carlosgj/Erin-Orion-Avionics/LED Board.brd

## EAGLE design LED Board.brd (2023-04-09)

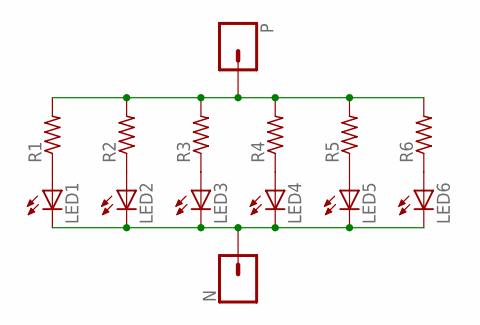
[picture p1: schematic LED Board.sch]

Parts:
LED1, LED2, LED3, LED4, LED5, LED6: LEDCHIPLED_1206; CHIPLED_1206
N: CONN_01; 1X01
P: CONN_01; 1X01
R1, R2, R3, R4, R5, R6: R-US_M1206; M1206

Connections:
unnamed: LED1.A, R1.1
unnamed: LED2.A, R2.1
unnamed: LED3.A, R3.1
unnamed: LED4.A, R4.1
unnamed: LED5.A, R5.1
unnamed: LED6.A, R6.1
unnamed: P.1, R1.2, R2.2, R3.2, R4.2, R5.2, R6.2
unnamed: LED1.C, LED2.C, LED3.C, LED4.C, LED5.C, LED6.C, N.1

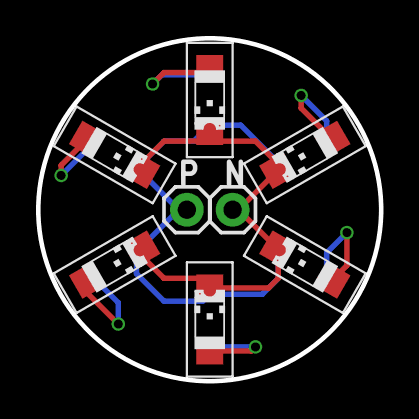
[picture p2: board LED Board.brd from above]

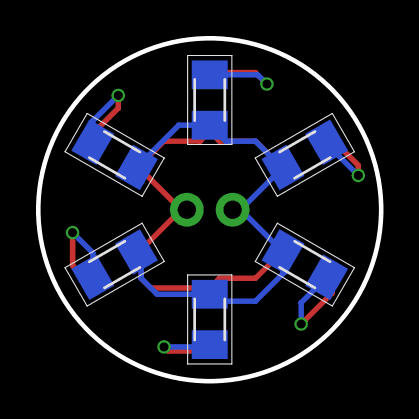
[picture p3: board LED Board.brd from below]

Board: 2 copper layers, 19.1 x 19.1 mm, 14 parts (6 on the bottom side), 8 nets.
