carlosgj/Erin-Orion-Avionics/Button Board.brd

## EAGLE design Button Board.brd (2023-03-30)

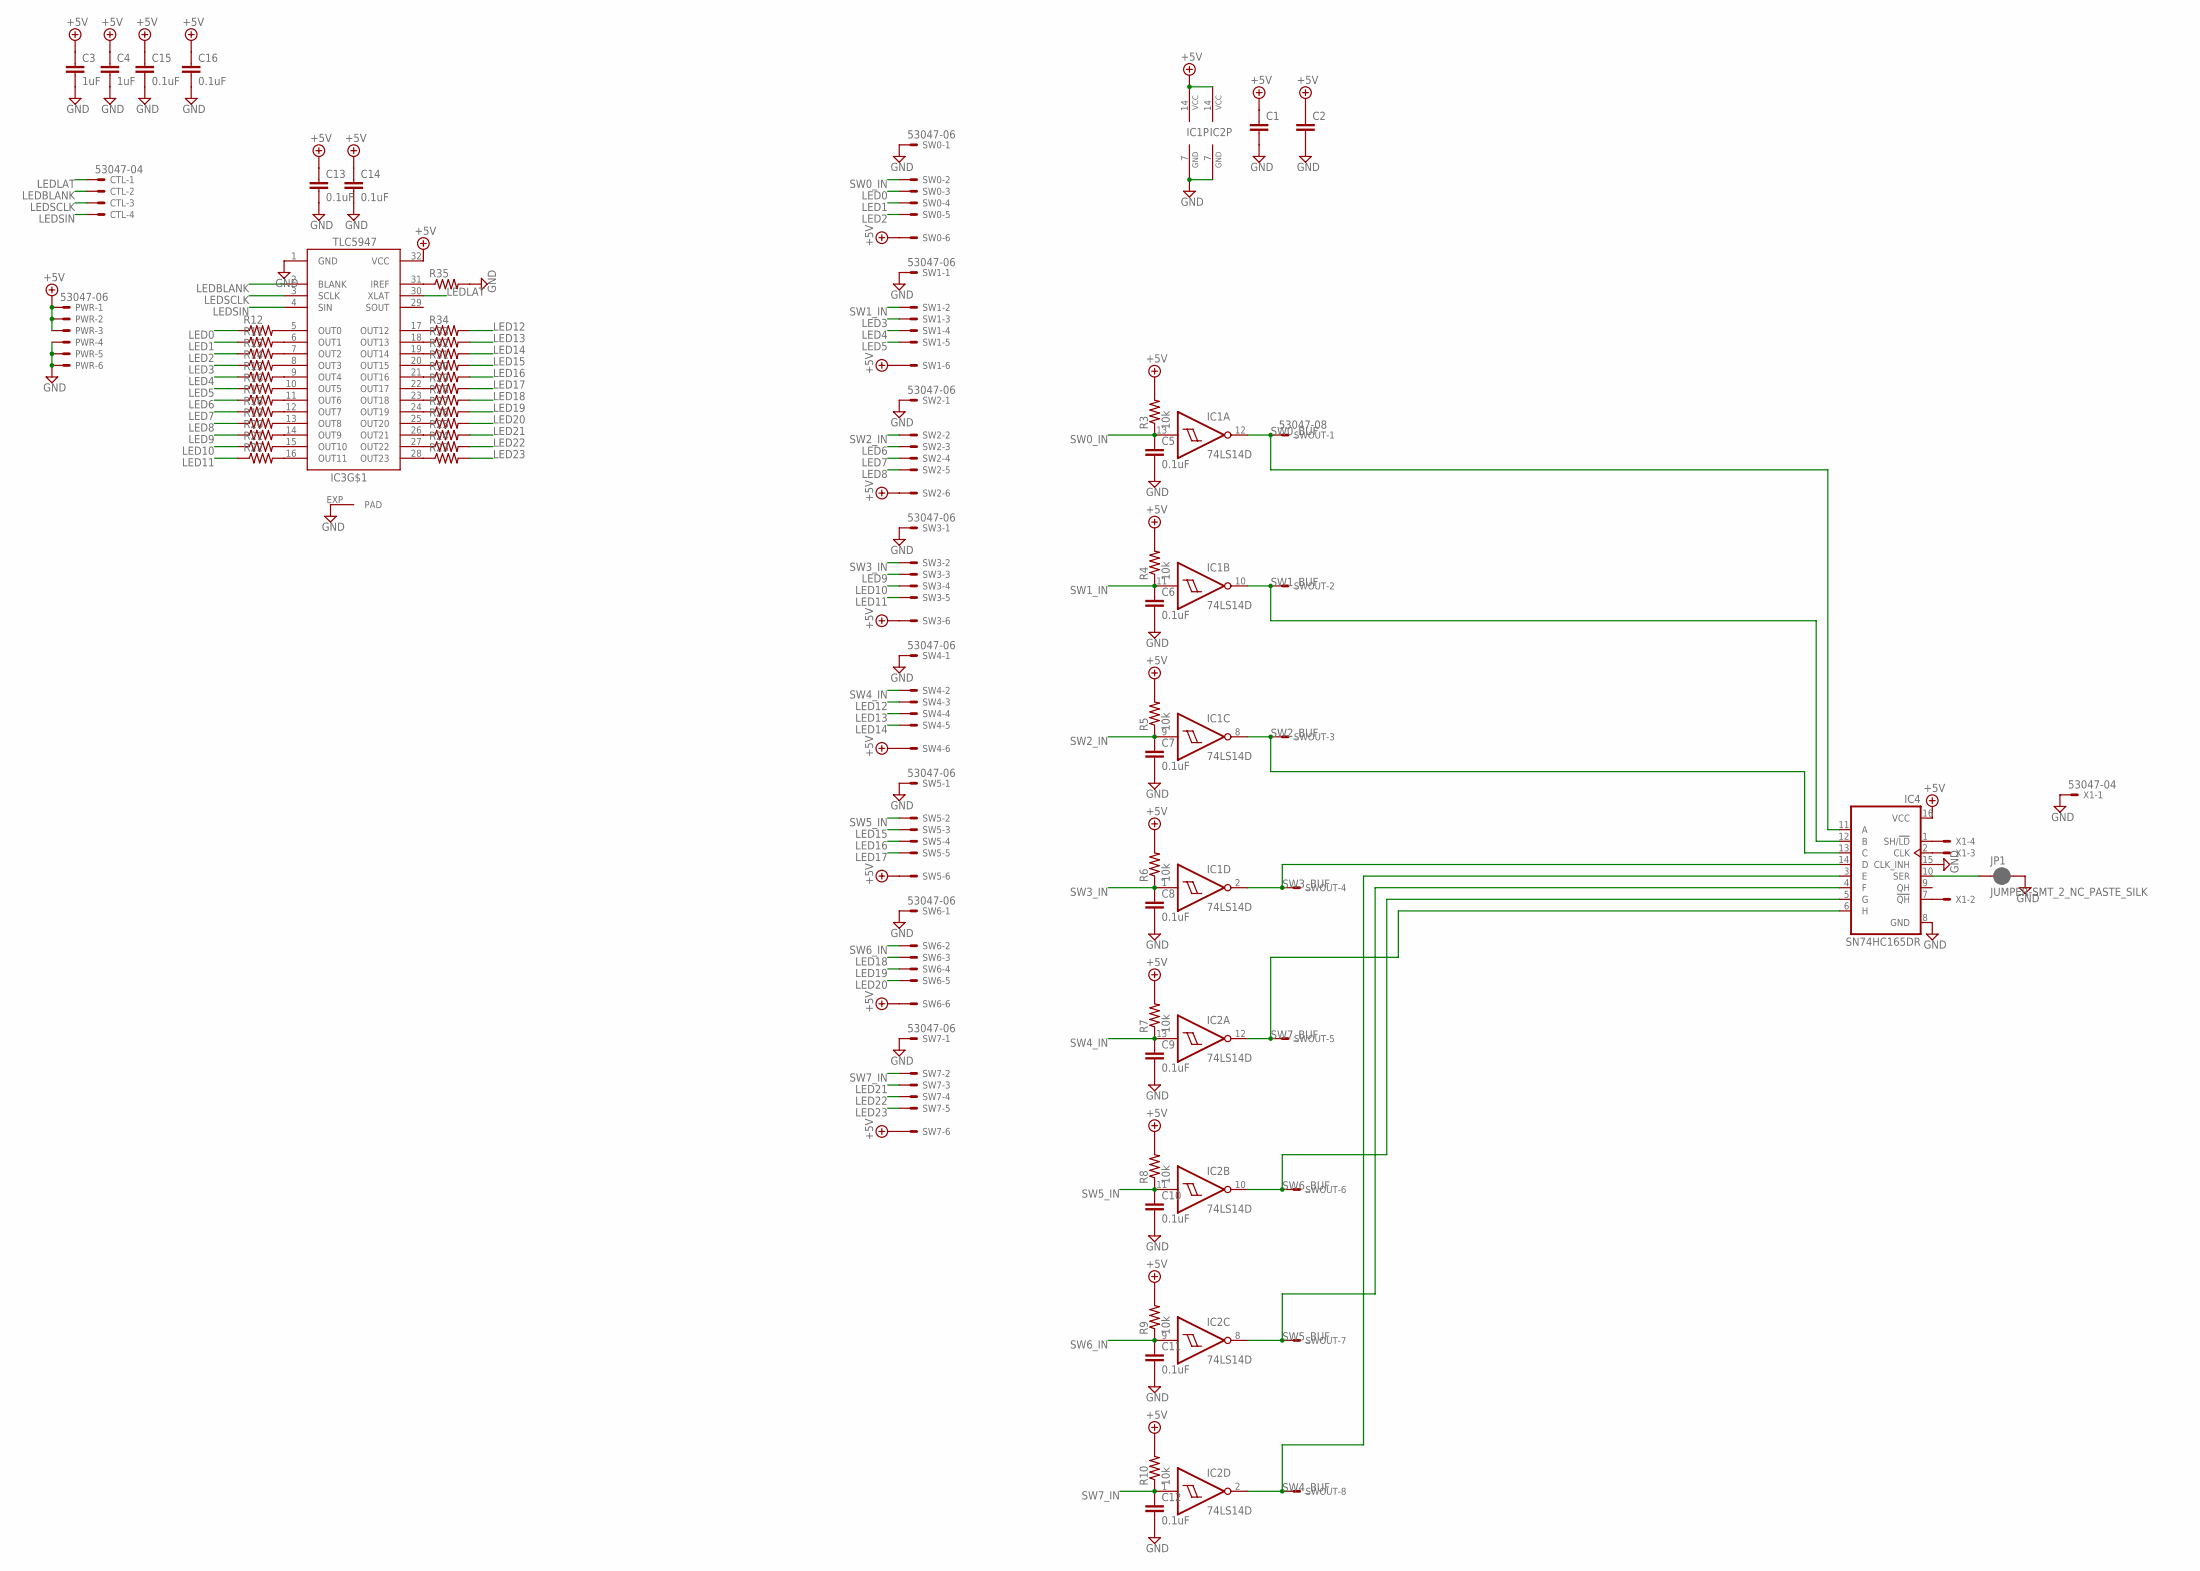
[picture p4: schematic Button Board.sch, Buttons]

Parts:
C1, C2: C-EUC1206; C1206
C3, C4: 1uF; C1206K
C5, C6, C7, C8, C9, C10, C11, C12, C13, C14: 0.1uF; C1206
C15, C16: 0.1uF; C1206K
CTL: 53047-04
IC1, IC2: 74LS14D; SO14
IC3: TLC5947-DAP; HTSSOP32DAP
IC4: SN74HC165DR; SO16
JP1: JUMPER-SMT_2_NC_PASTE_SILK; SMT-JUMPER_2_NC_PASTE_SILK
PWR: 53047-06
R3, R4, R5, R6, R7, R8, R9, R10: 10k; M1206
R11, R12, R13, R14, R15, R16, R17, R18, R19, R20, R21, R22, R23, R24, R25, R26, R27, R28, R29, R30, R31, R32, R33, R34, R35: R-US_M1206; M1206
SW0, SW1, SW2, SW3, SW4, SW5, SW6, SW7: 53047-06
SWOUT: 53047-08
X1: 53047-04

Connections:
+5V: C1.1, C2.1, C3.1, C4.1, C13.1, C14.1, C15.1, C16.1, IC1.14 (VCC), IC2.14 (VCC), IC3.32 (VCC), IC4.16 (VCC), PWR.1, PWR.2, PWR.3, R3.2, R4.2, R5.2, R6.2, R7.2, R8.2, R9.2, R10.2, SW0.6, SW1.6, SW2.6, SW3.6, SW4.6, SW5.6, SW6.6, SW7.6
GND: C1.2, C2.2, C3.2, C4.2, C5.2, C6.2, C7.2, C8.2, C9.2, C10.2, C11.2, C12.2, C13.2, C14.2, C15.2, C16.2, IC1.7 (GND), IC2.7 (GND), IC3.1 (GND), IC3.EXP (PAD), IC4.8 (GND), IC4.15 (CLK_INH), JP1.2, PWR.4, PWR.5, PWR.6, R35.2, SW0.1, SW1.1, SW2.1, SW3.1, SW4.1, SW5.1, SW6.1, SW7.1, X1.1
LED0: R12.1, SW0.3
LED1: R11.1, SW0.4
LED2: R13.1, SW0.5
LED3: R14.1, SW1.3
LED4: R15.1, SW1.4
LED5: R16.1, SW1.5
LED6: R17.1, SW2.3
LED7: R18.1, SW2.4
LED8: R19.1, SW2.5
LED9: R20.1, SW3.3
LED10: R21.1, SW3.4
LED11: R22.1, SW3.5
LED12: R34.2, SW4.3
LED13: R33.2, SW4.4
LED14: R32.2, SW4.5
LED15: R31.2, SW5.3
LED16: R30.2, SW5.4
LED17: R29.2, SW5.5
LED18: R28.2, SW6.3
LED19: R27.2, SW6.4
LED20: R26.2, SW6.5
LED21: R25.2, SW7.3
LED22: R24.2, SW7.4
LED23: R23.2, SW7.5
LEDBLANK: CTL.2, IC3.2 (BLANK)
LEDLAT: CTL.1, IC3.30 (XLAT)
LEDSCLK: CTL.3, IC3.3 (SCLK)
LEDSIN: CTL.4, IC3.4 (SIN)
unnamed: IC4.1 (SH/!LD), X1.4
unnamed: IC4.2 (CLK), X1.3
unnamed: IC3.5 (OUT0), R12.2
unnamed: IC3.6 (OUT1), R11.2
unnamed: IC3.7 (OUT2), R13.2
unnamed: IC3.8 (OUT3), R14.2
unnamed: IC3.9 (OUT4), R15.2
unnamed: IC3.11 (OUT6), R17.2
unnamed: IC3.12 (OUT7), R18.2
unnamed: IC3.13 (OUT8), R19.2
unnamed: IC3.15 (OUT10), R21.2
unnamed: IC3.16 (OUT11), R22.2
unnamed: IC3.28 (OUT23), R23.1
unnamed: IC3.27 (OUT22), R24.1
unnamed: IC3.26 (OUT21), R25.1
unnamed: IC3.25 (OUT20), R26.1
unnamed: IC3.24 (OUT19), R27.1
unnamed: IC3.23 (OUT18), R28.1
unnamed: IC3.22 (OUT17), R29.1
unnamed: IC3.21 (OUT16), R30.1
unnamed: IC3.20 (OUT15), R31.1
unnamed: IC3.19 (OUT14), R32.1
unnamed: IC3.18 (OUT13), R33.1
unnamed: IC3.17 (OUT12), R34.1
unnamed: IC3.10 (OUT5), R16.2
unnamed: IC3.14 (OUT9), R20.2
unnamed: IC3.31 (IREF), R35.1
unnamed: IC4.7 (!QH), X1.2
unnamed: IC4.10 (SER), JP1.1
SW0_BUF: IC1.12 (O), IC4.11 (A), SWOUT.1
SW0_IN: C5.1, IC1.13 (I), R3.1, SW0.2
SW1_BUF: IC1.10 (O), IC4.12 (B), SWOUT.2
SW1_IN: C6.1, IC1.11 (I), R4.1, SW1.2
SW2_BUF: IC1.8 (O), IC4.13 (C), SWOUT.3
SW2_IN: C7.1, IC1.9 (I), R5.1, SW2.2
SW3_BUF: IC1.2 (O), IC4.14 (D), SWOUT.4
SW3_IN: C8.1, IC1.1 (I), R6.1, SW3.2
SW4_BUF: IC2.2 (O), IC4.3 (E), SWOUT.8
SW4_IN: C9.1, IC2.13 (I), R7.1, SW4.2
SW5_BUF: IC2.8 (O), IC4.4 (F), SWOUT.7
SW5_IN: C10.1, IC2.11 (I), R8.1, SW5.2
SW6_BUF: IC2.10 (O), IC4.5 (G), SWOUT.6
SW6_IN: C11.1, IC2.9 (I), R9.1, SW6.2
SW7_BUF: IC2.12 (O), IC4.6 (H), SWOUT.5
SW7_IN: C12.1, IC2.1 (I), R10.1, SW7.2

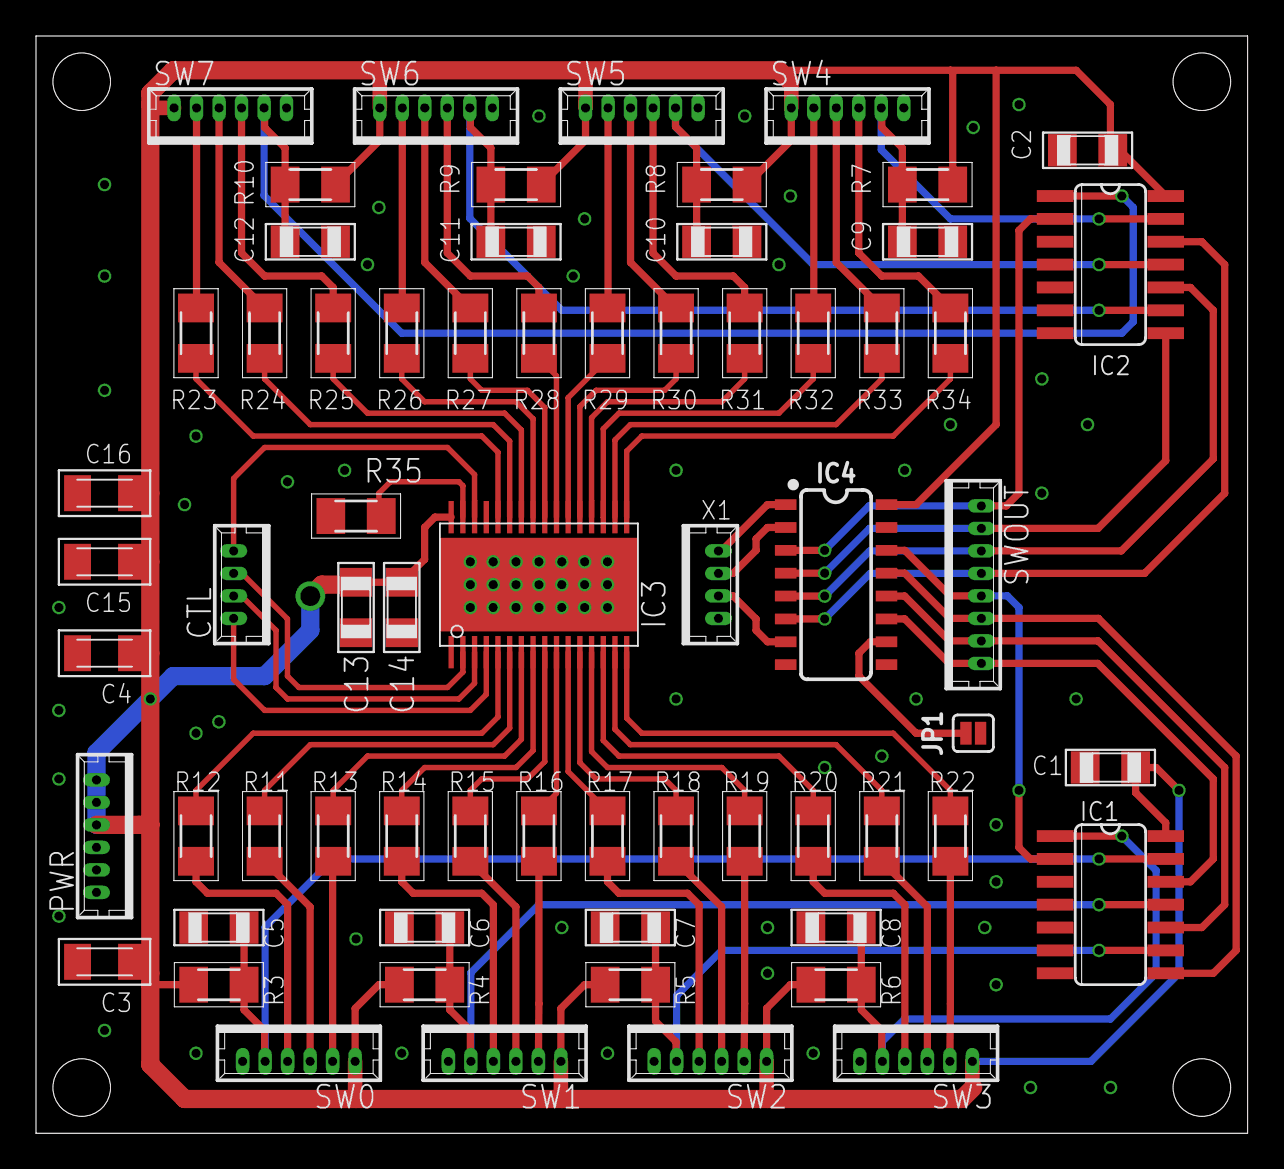
[picture p5: board Button Board.brd from above]

Board: 2 copper layers, 67.3 x 61.0 mm, 66 parts (0 on the bottom side), 75 nets.
