carlosgj/Erin-Orion-Avionics/Control Board.brd

## EAGLE design Control Board.brd (2023-03-30)

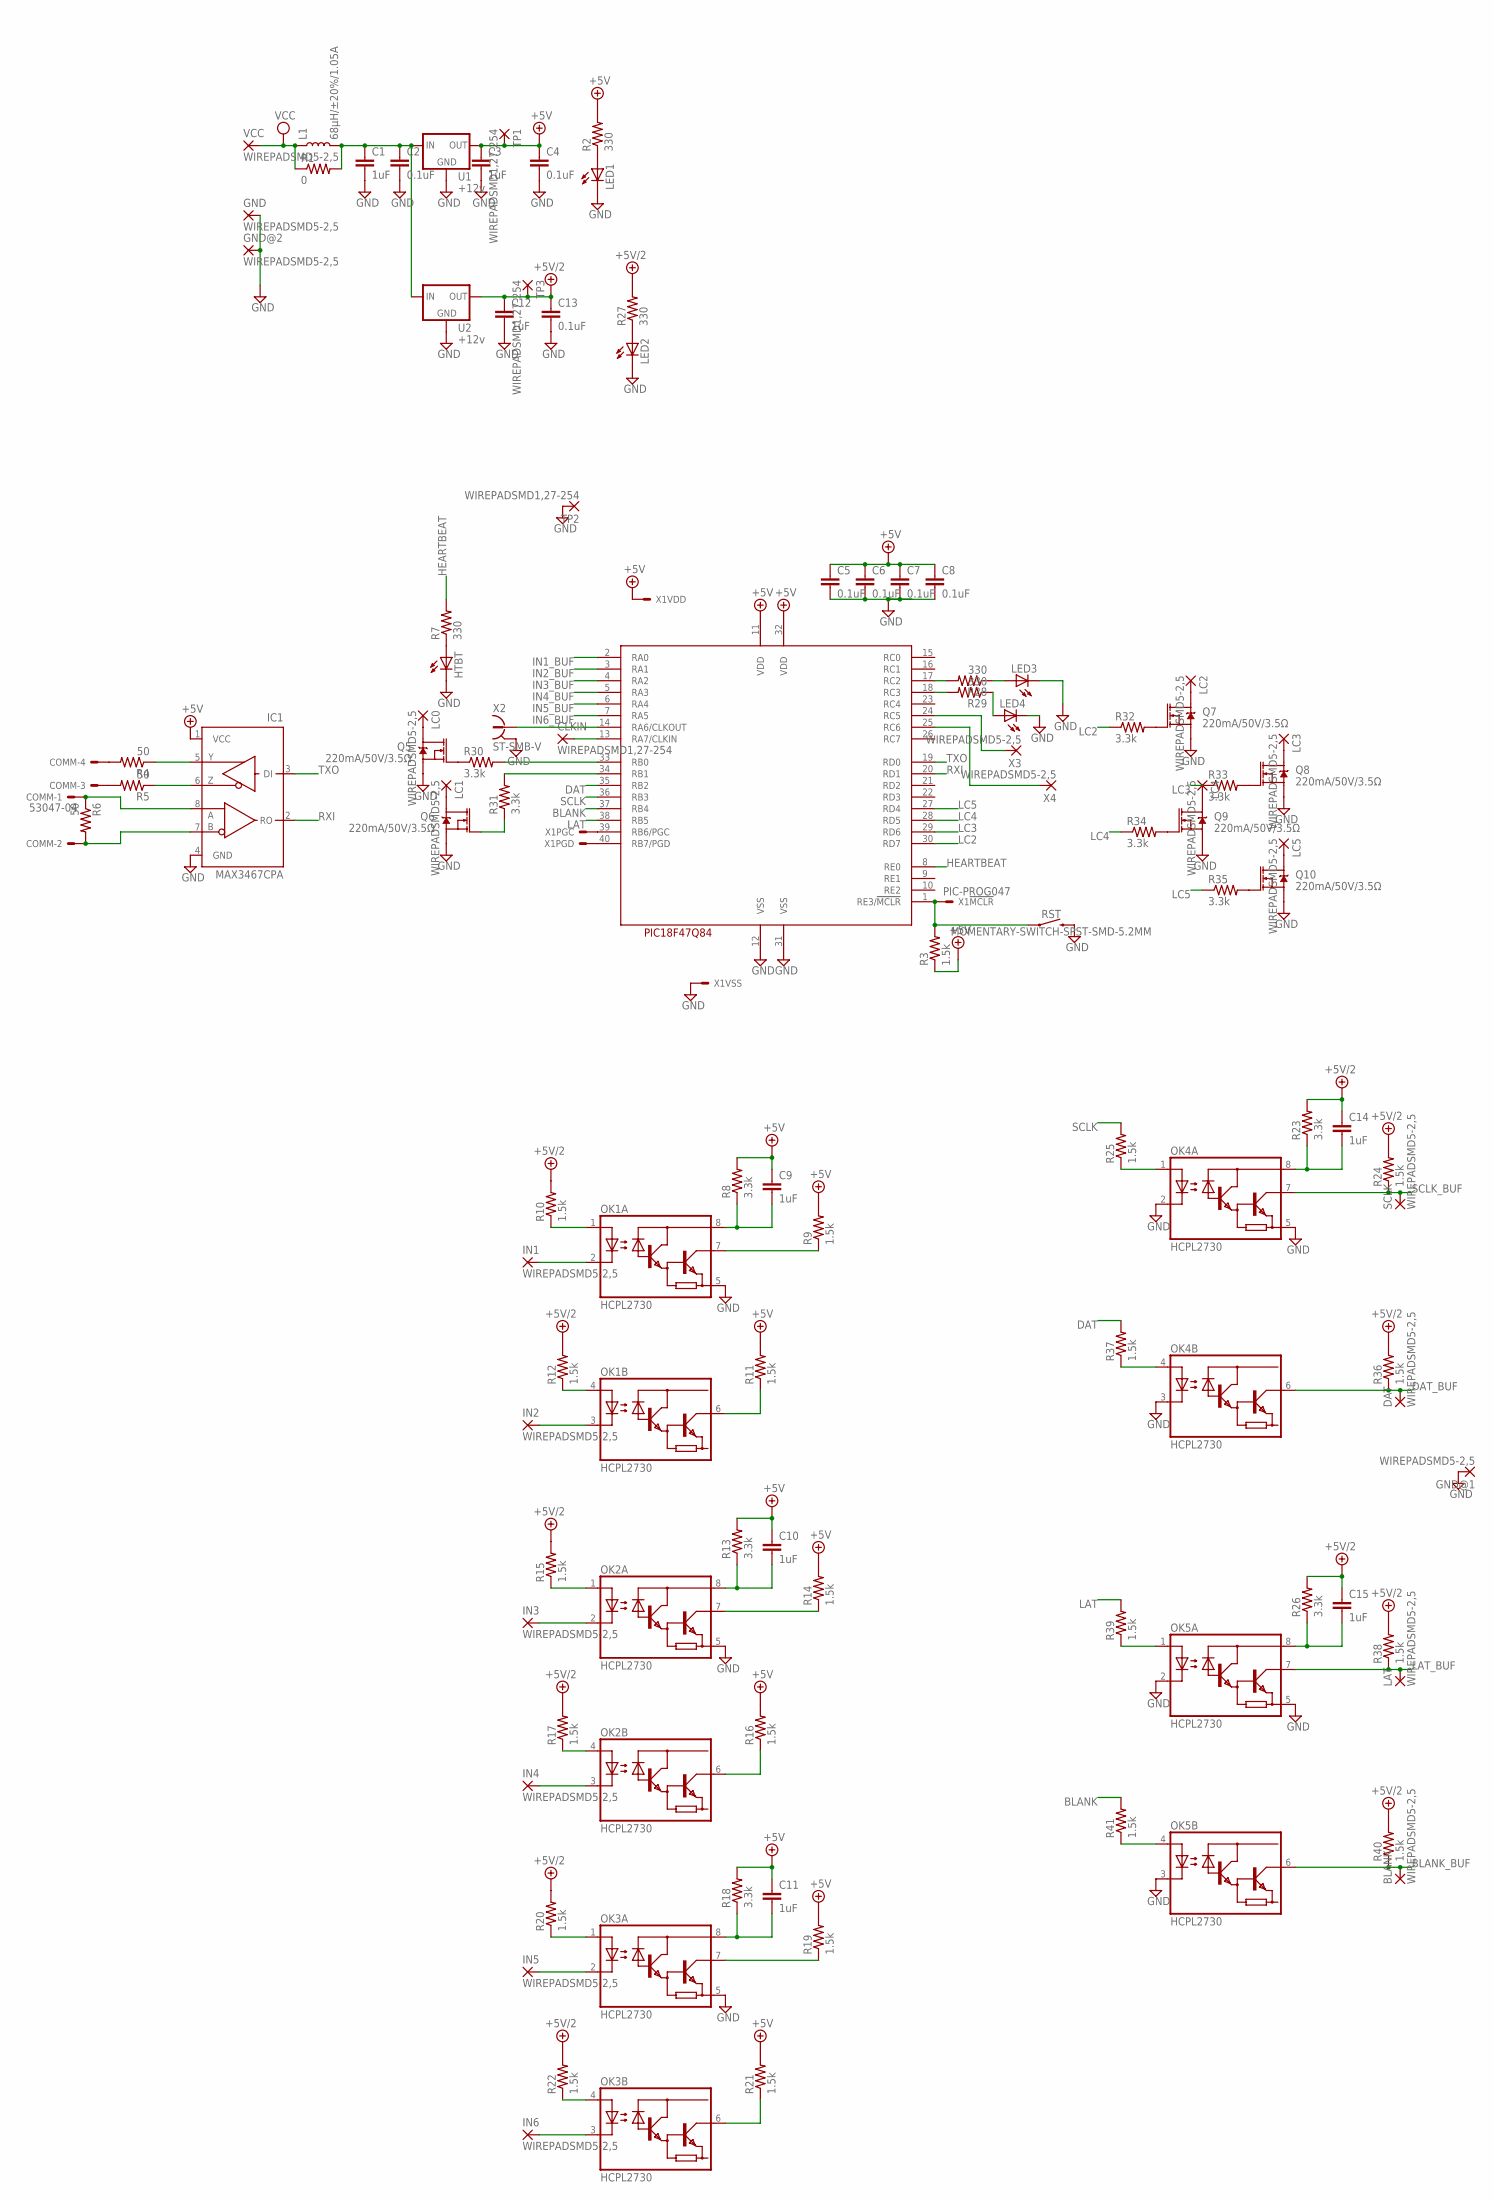
[picture p6: schematic Control Board.sch]

Parts:
BLANK: WIREPADSMD5-2,5; 5-2,5
C1, C3, C9, C10, C11, C12, C14, C15: 1uF; C1206
C2, C4, C5, C6, C7, C8, C13: 0.1uF; C1206
CLKIN: WIREPADSMD1,27-254; SMD1,27-2,54
COMM: 53047-04
DAT: WIREPADSMD5-2,5; 5-2,5
GND: WIREPADSMD5-2,5; 5-2,5
GND@1, GND@2: WIREPADSMD5-2,5; 5-2,5
HTBT: LEDCHIPLED_1206; CHIPLED_1206
IC1: MAX3467CPA; SO08
IN1, IN2, IN3, IN4, IN5, IN6: WIREPADSMD5-2,5; 5-2,5
L1: 68µH/±20%/1.05A; CR75
LAT: WIREPADSMD5-2,5; 5-2,5
LC0, LC1, LC2, LC3, LC4, LC5: WIREPADSMD5-2,5; 5-2,5
LED1, LED2, LED3, LED4: LEDCHIPLED_1206; CHIPLED_1206
OK1, OK2, OK3, OK4, OK5: HCPL2730; DIL08
Q5, Q6, Q7, Q8, Q9, Q10: 220mA/50V/3.5Ω; SOT23-3
R1: 0; M1206
R2, R7, R27, R28, R29: 330; M1206
R3, R9, R10, R11, R12, R14, R15, R16, R17, R19, R20, R21, R22, R24, R25, R36, R37, R38, R39, R40, R41: 1.5k; M1206
R4, R5, R6: 50; M1206
R8, R13, R18, R23, R26, R30, R31, R32, R33, R34, R35: 3.3k; M1206
RST: MOMENTARY-SWITCH-SPST-SMD-5.2MM; TACTILE_SWITCH_SMD_5.2MM
SCLK: WIREPADSMD5-2,5; 5-2,5
TP1, TP2, TP3: WIREPADSMD1,27-254; SMD1,27-2,54
U1, U2: +12v; TO-252
U$1: PIC18F47Q84; DIL40
VCC: WIREPADSMD5-2,5; 5-2,5
X1: PIC-PROG047; 53047-05
X2: ST-SMB-V
X3, X4: WIREPADSMD5-2,5; 5-2,5

Connections:
+5V: C3.1, C4.1, C5.1, C6.1, C7.1, C8.1, C9.1, C10.1, C11.1, IC1.1 (VCC), R2.2, R3.1, R8.2, R9.2, R11.2, R13.2, R14.2, R16.2, R18.2, R19.2, R21.2, TP1.1, U1.2 (OUT), U$1.11 (VDD), U$1.32 (VDD), X1.2
+5V/2: C12.1, C13.1, C14.1, C15.1, R10.2, R12.2, R15.2, R17.2, R20.2, R22.2, R23.2, R24.2, R26.2, R27.2, R36.2, R38.2, R40.2, TP3.1, U2.2 (OUT)
BLANK: R41.2, U$1.37 (RB4)
BLANK_BUF: BLANK.1, OK5.6 (VO2), R40.1
DAT: R37.2, U$1.35 (RB2)
DAT_BUF: DAT.1, OK4.6 (VO2), R36.1
GND: C1.2, C2.2, C3.2, C4.2, C5.2, C6.2, C7.2, C8.2, C12.2, C13.2, GND.1, GND@1.1, GND@2.1, HTBT.C, IC1.4 (GND), LED1.C, LED2.C, LED3.C, LED4.C, OK1.5 (GND), OK2.5 (GND), OK3.5 (GND), OK4.2 (C1), OK4.3 (C2), OK4.5 (GND), OK5.2 (C1), OK5.3 (C2), OK5.5 (GND), Q5.2 (S), Q6.2 (S), Q7.2 (S), Q8.2 (S), Q9.2 (S), Q10.2 (S), RST.3 (2), TP2.1, U1.3 (GND), U2.3 (GND), U$1.12 (VSS), U$1.31 (VSS), X1.3, X2.2, X2.3 (2), X2.4 (2), X2.5 (2)
HEARTBEAT: R7.2, U$1.8 (RE0)
IN1: IN1.1, OK1.2 (C1)
IN1_BUF: OK1.7 (VO1), R9.1, U$1.2 (RA0)
IN2: IN2.1, OK1.3 (C2)
IN2_BUF: OK1.6 (VO2), R11.1, U$1.3 (RA1)
IN3: IN3.1, OK2.2 (C1)
IN3_BUF: OK2.7 (VO1), R14.1, U$1.4 (RA2)
IN4: IN4.1, OK2.3 (C2)
IN4_BUF: OK2.6 (VO2), R16.1, U$1.5 (RA3)
IN5: IN5.1, OK3.2 (C1)
IN5_BUF: OK3.7 (VO1), R19.1, U$1.6 (RA4)
IN6: IN6.1, OK3.3 (C2)
IN6_BUF: OK3.6 (VO2), R21.1, U$1.7 (RA5)
LAT: R39.2, U$1.38 (RB5)
LAT_BUF: LAT.1, OK5.7 (VO1), R38.1
LC2: R32.1, U$1.30 (RD7)
LC3: R33.1, U$1.29 (RD6)
LC4: R34.1, U$1.28 (RD5)
LC5: R35.1, U$1.27 (RD4)
unnamed: C1.1, C2.1, L1.P$2 (2), R1.2, U1.1 (IN), U2.1 (IN)
unnamed: LED1.A, R2.1
unnamed: R3.2, RST.1, U$1.1 (RE3/!MCLR), X1.1
unnamed: U$1.40 (RB7/PGD), X1.4
unnamed: U$1.39 (RB6/PGC), X1.5
unnamed: U$1.14 (RA6/CLKOUT), X2.1
unnamed: IC1.5 (Y), R4.1
unnamed: IC1.6 (Z), R5.1
unnamed: COMM.1, IC1.8 (A), R6.1
unnamed: COMM.2, IC1.7 (B), R6.2
unnamed: COMM.4, R4.2
unnamed: COMM.3, R5.2
unnamed: HTBT.A, R7.1
unnamed: CLKIN.1, U$1.13 (RA7/CLKIN)
unnamed: C9.2, OK1.8 (VCC), R8.1
unnamed: C10.2, OK2.8 (VCC), R13.1
unnamed: OK2.1 (A1), R15.1
unnamed: OK1.1 (A1), R10.1
unnamed: OK2.4 (A2), R17.1
unnamed: OK1.4 (A2), R12.1
unnamed: C11.2, OK3.8 (VCC), R18.1
unnamed: OK3.1 (A1), R20.1
unnamed: OK3.4 (A2), R22.1
unnamed: C14.2, OK4.8 (VCC), R23.1
unnamed: OK4.1 (A1), R25.1
unnamed: C15.2, OK5.8 (VCC), R26.1
unnamed: OK4.4 (A2), R37.1
unnamed: OK5.1 (A1), R39.1
unnamed: LED2.A, R27.1
unnamed: OK5.4 (A2), R41.1
unnamed: R28.2, U$1.17 (RC2)
unnamed: R29.2, U$1.18 (RC3)
unnamed: LED3.A, R28.1
unnamed: LED4.A, R29.1
unnamed: R30.2, U$1.33 (RB0)
unnamed: R31.2, U$1.34 (RB1)
unnamed: Q5.1 (G), R30.1
unnamed: Q6.1 (G), R31.1
unnamed: LC0.1, Q5.3 (D)
unnamed: LC1.1, Q6.3 (D)
unnamed: Q7.1 (G), R32.2
unnamed: Q8.1 (G), R33.2
unnamed: Q9.1 (G), R34.2
unnamed: Q10.1 (G), R35.2
unnamed: LC2.1, Q7.3 (D)
unnamed: LC3.1, Q8.3 (D)
unnamed: LC4.1, Q9.3 (D)
unnamed: LC5.1, Q10.3 (D)
unnamed: U$1.25 (RC6), X4.1
unnamed: U$1.24 (RC5), X3.1
RXI: IC1.2 (RO), U$1.20 (RD1)
SCLK: R25.2, U$1.36 (RB3)
SCLK_BUF: OK4.7 (VO1), R24.1, SCLK.1
TXO: IC1.3 (DI), U$1.19 (RD0)
VCC: L1.P$1 (1), R1.1, VCC.1

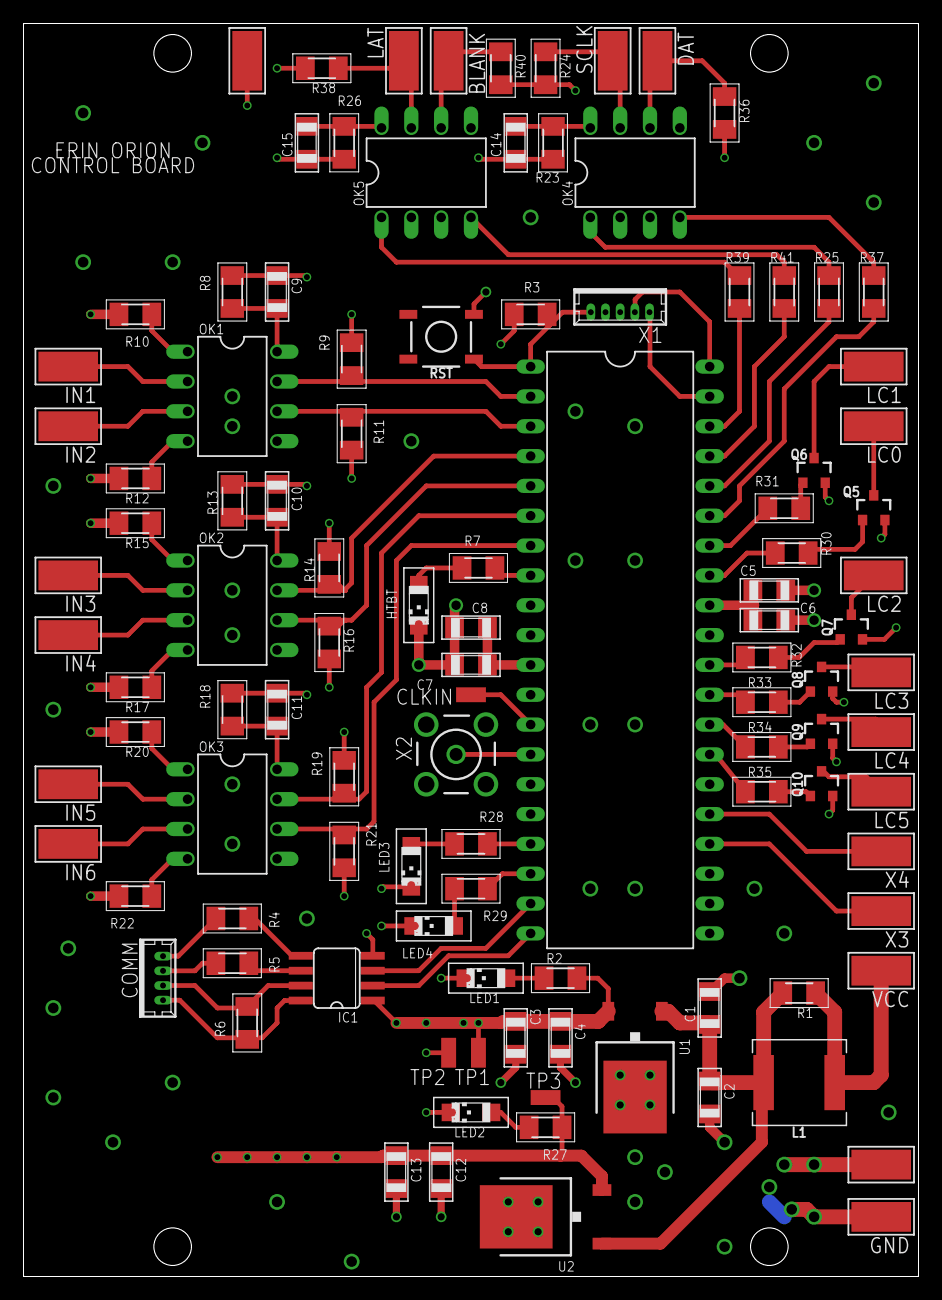
[picture p7: board Control Board.brd from above]

Board: 4 copper layers, 76.2 x 106.7 mm, 107 parts (0 on the bottom side), 81 nets.
