carlosgj/Erin-Orion-Avionics/ErinOrion.X/HDLC.h

#ifndef HDLC_H
#define	HDLC_H

#include <xc.h>
#include <string.h>
#include "common.h"
#include "commConstants.h"
#include "FIFO.h"
#include "SerialManager.h"
#include "UART.h"

#define HDLC_START      (0x7f)
#define HDLC_STOP       (0x7e)
#define HDLC_ESCAPE     (0x7d)
#define HDLC_TS_ARM     (0x7c)
#define HDLC_TS_ABORT   (0x7b)

#define MAX_RX_SIZE     (16)
#define RX_MSG_QUEUE    (4)
#define FRAMEBUF_SIZE   (MAX_RX_SIZE+2)

//Checks if a byte is a control byte
#define IS_CONTROL(x)   (((x ^ 0b01111100) & 0b11111100) == 0 )

unsigned char frameBuf[FRAMEBUF_SIZE];
unsigned char framePtr = 0;

#define MSGBUF_WAITING ((unsigned char)(msgRxPtr-msgProcessPtr))

void HDLCInit(void);

// Encode some bytes and send
void sendBuf(uint8_t *buf, unsigned int count);

//This function is responsible for taking bytes out of the 422 Rx queue and 
// chunking them up into HDLC frames.
void implementRx(FIFO *RxQueue);

//This function checks the contents of frameBuf to make sure it's a valid HDLC frame, 
// and if so, extracts it into a message
void validateFrame(unsigned char len);
#endif
