carlosgj/Erin-Orion-Avionics/(commit log)

2023-03-30 Board designs
    [Aux Power Board_top_bom.csv, Aux Power Board_top_bom.xlsx, Button Board.brd, Button Board.sch, Button Board_top_bom.csv, Button Board_top_bom.xlsx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]
2023-04-09 LED Board
    [LED Board.brd, LED Board.sch]
2023-04-09 Using temperature to add more randomness to PRNG
2023-04-09 Working on thruster/maneuver logic
2023-04-11 Working on thruster timing
2023-04-12 Final software (hopefully)!
    [Control Board.sch]
